FrancescoLanthaler/BeeBeeAte/3D-Files/STL/Omni Kupplung.stl

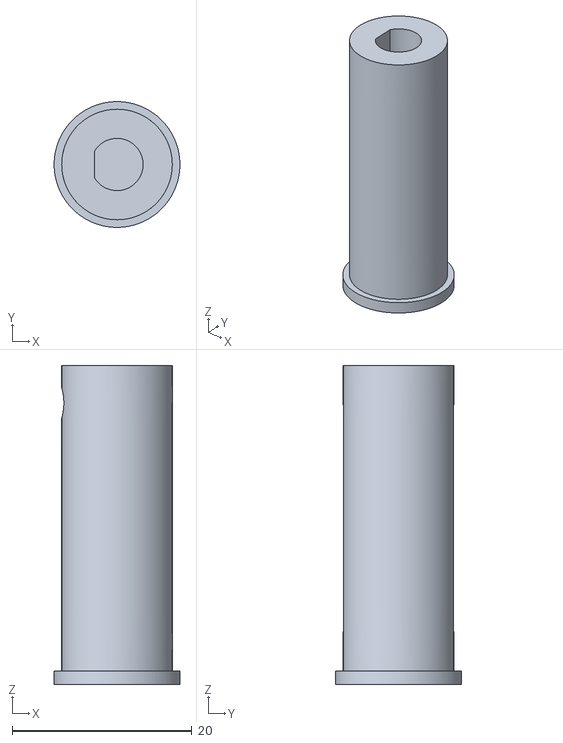
[picture p1: CAD file, 2021-12-13]
3D-Files/STL/Omni Kupplung.stl
14.0 x 14.0 x 35.5
