FrancescoLanthaler/BeeBeeAte/3D-Files/STL/BeeBeeAte-BotBoard-Case_Test1.stl

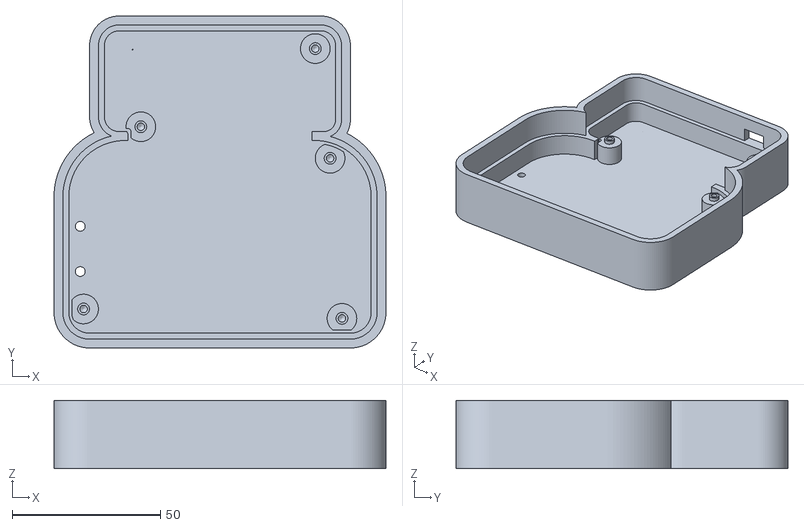
[picture p2: CAD file, 2021-11-17]
3D-Files/STL/BeeBeeAte-BotBoard-Case_Test1.stl
112.0 x 112.0 x 23.0
