FrancescoLanthaler/BeeBeeAte/3D-Files/STL/BeeBeeAte-BotBoard-Cover_Test1.stl

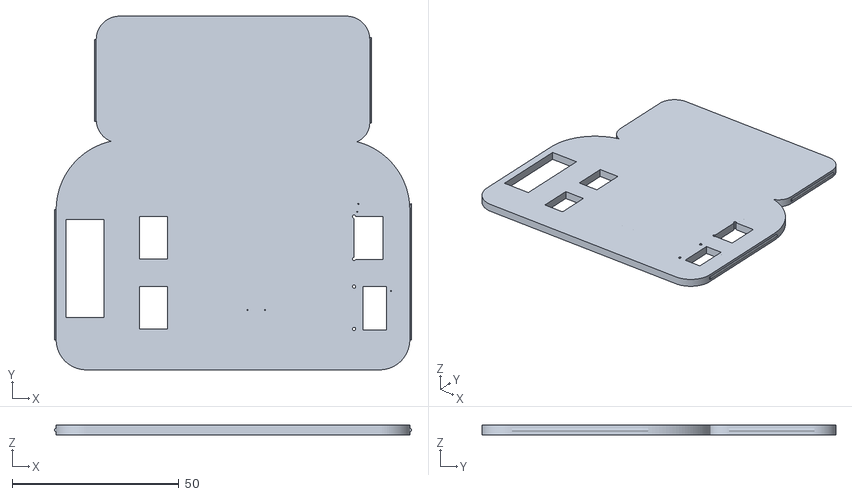
[picture p3: CAD file, 2021-11-17]
3D-Files/STL/BeeBeeAte-BotBoard-Cover_Test1.stl
107.0 x 106.0 x 3.00
