FrancescoLanthaler/BeeBeeAte/3D-Files/STL/KupplungOmni.stl

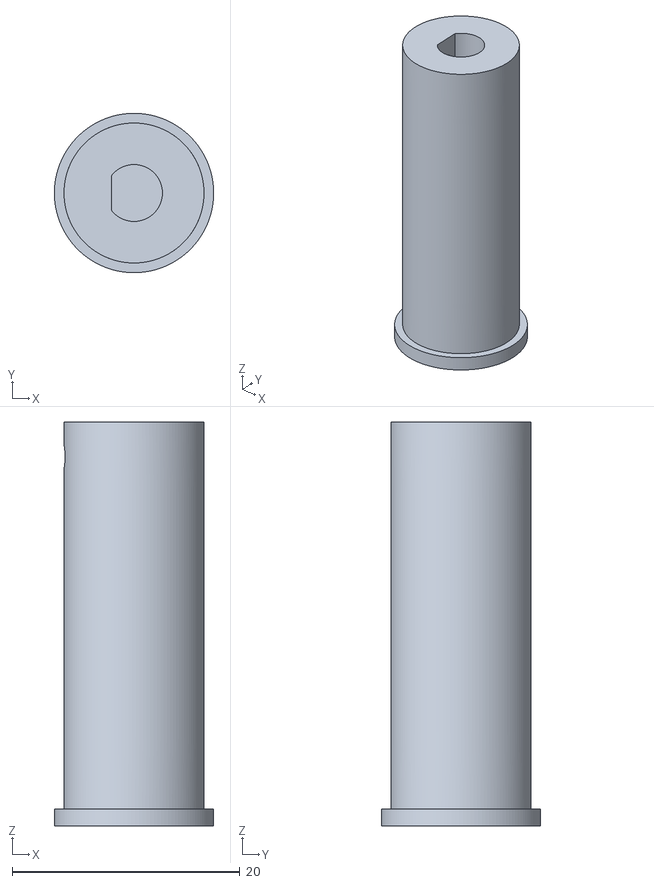
[picture p4: CAD file, 2021-11-17]
3D-Files/STL/KupplungOmni.stl
14.0 x 14.0 x 35.5
