FrancescoLanthaler/BeeBeeAte/3D-Files/STL/Fernsteuerung Cover Test 4.stl

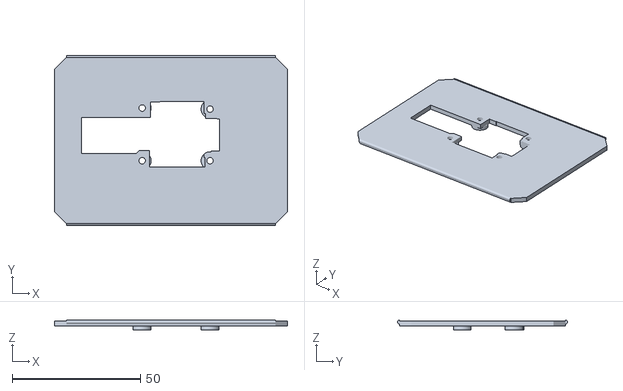
[picture p5: CAD file, 2021-11-17]
3D-Files/STL/Fernsteuerung Cover Test 4.stl
91.0 x 66.5 x 3.81
