FrancescoLanthaler/BeeBeeAte/3D-Files/STL/Cover-Test2.stl

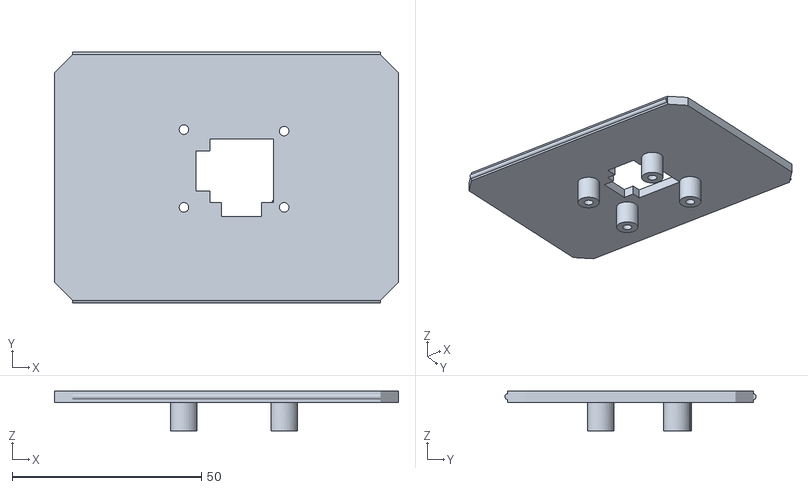
[picture p6: CAD file, 2021-11-06]
3D-Files/STL/Cover-Test2.stl
91.0 x 66.5 x 10.6
