FrancescoLanthaler/BeeBeeAte/3D-Files/STL/Cover-Test3.stl

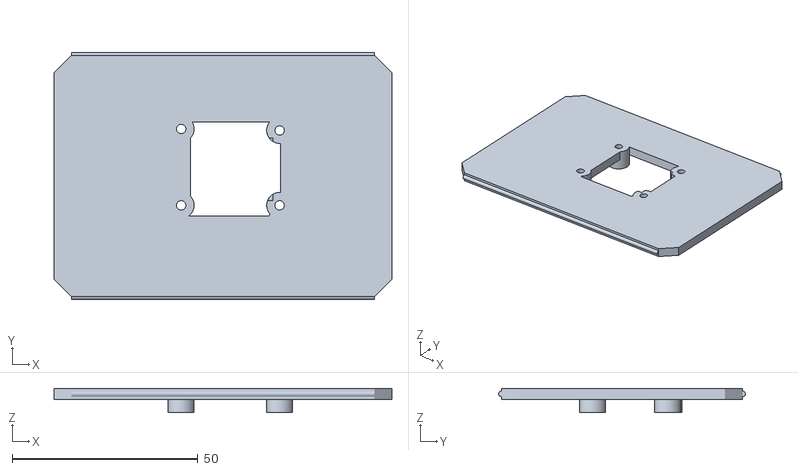
[picture p7: CAD file, 2021-11-06]
3D-Files/STL/Cover-Test3.stl
91.0 x 66.5 x 6.56
