FrancescoLanthaler/BeeBeeAte/(list of files, cad)

Other CAD files:
3D-Files/STL/BeeBeeAte-BotBoard-Case_Test2.stl
3D-Files/STL/KupplungOmniV2.stl
