FrancescoLanthaler/BeeBeeAte/EAGLE/Version 1/BotBoardBRD.pdf

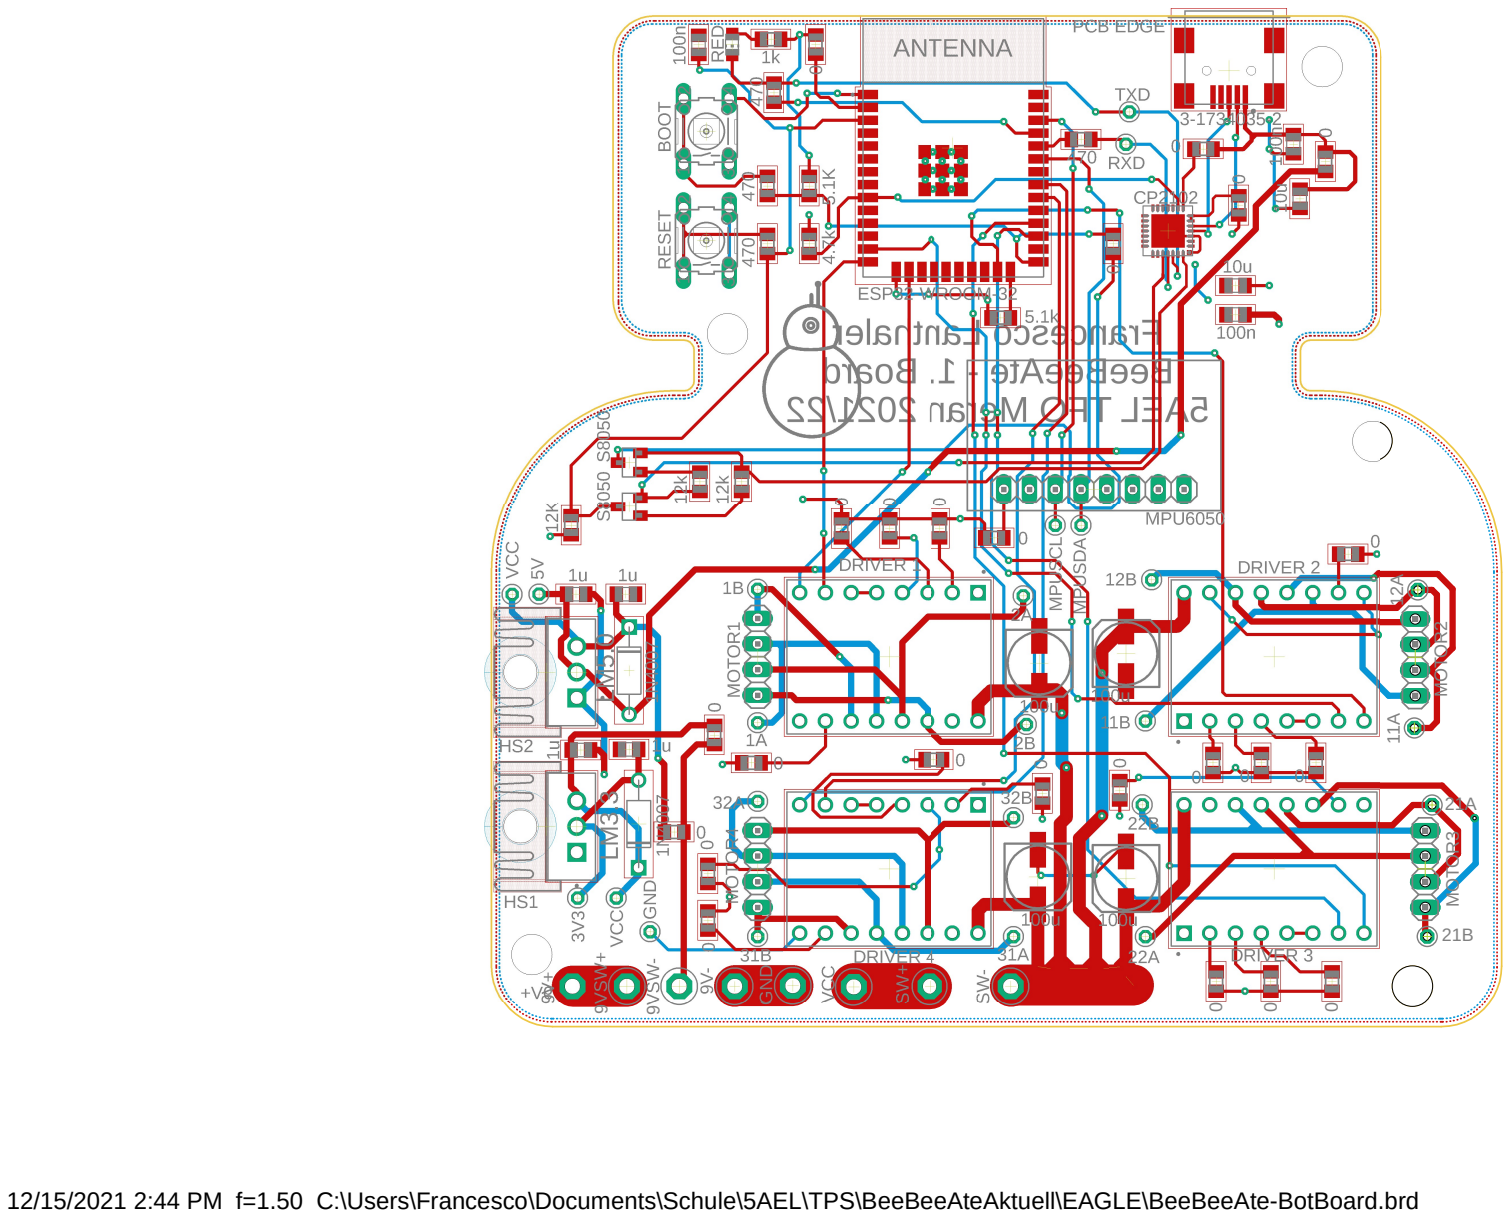
[picture p8: page 1]
9V+ MOTOR2 MOTOR3 SW+ SW- 0; 21B GND; VCC 9VSW⁺; 9VSW⁻

12/15/2021 2:44 PM f=1.50 C:\Users\Francesco\Documents\Schule\5AEL\TPS\BeeBeeAteAktuell\EAGLE\BeeBeeAte-BotBoard.brd
