FrancescoLanthaler/BeeBeeAte/EAGLE/Version 1/BotBoardSCH.pdf

# Stromversorgung

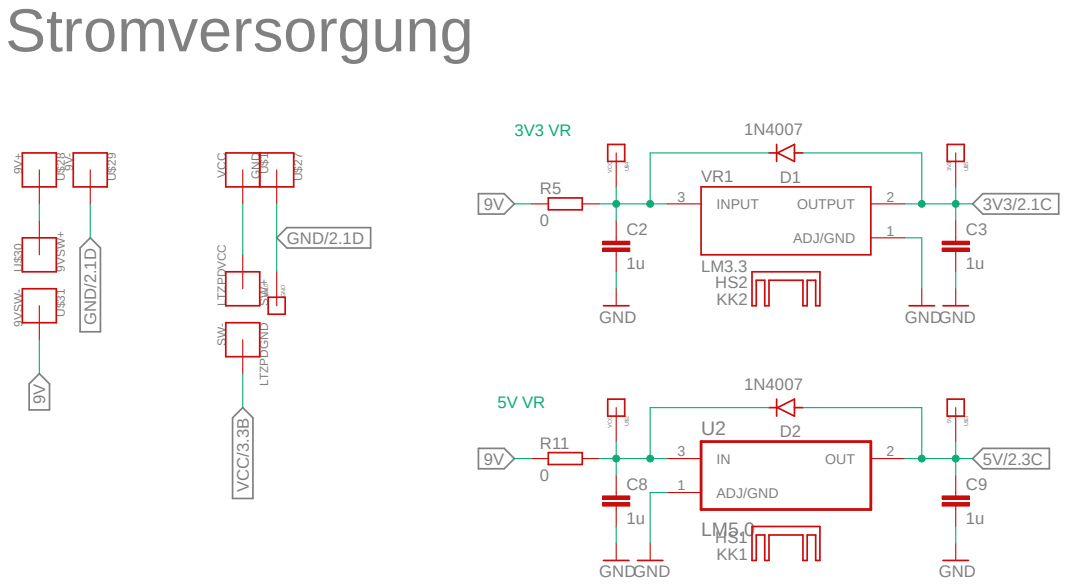
[picture p9: page 1]

12/15/2021 2:44 PM C:\Users\Francesco\Documents\Schule\5AEL\TPS\BeeBeeAteAktuell\EAGLE\BeeBeeAte-BotBoard.sch (Sheet: 1/4)

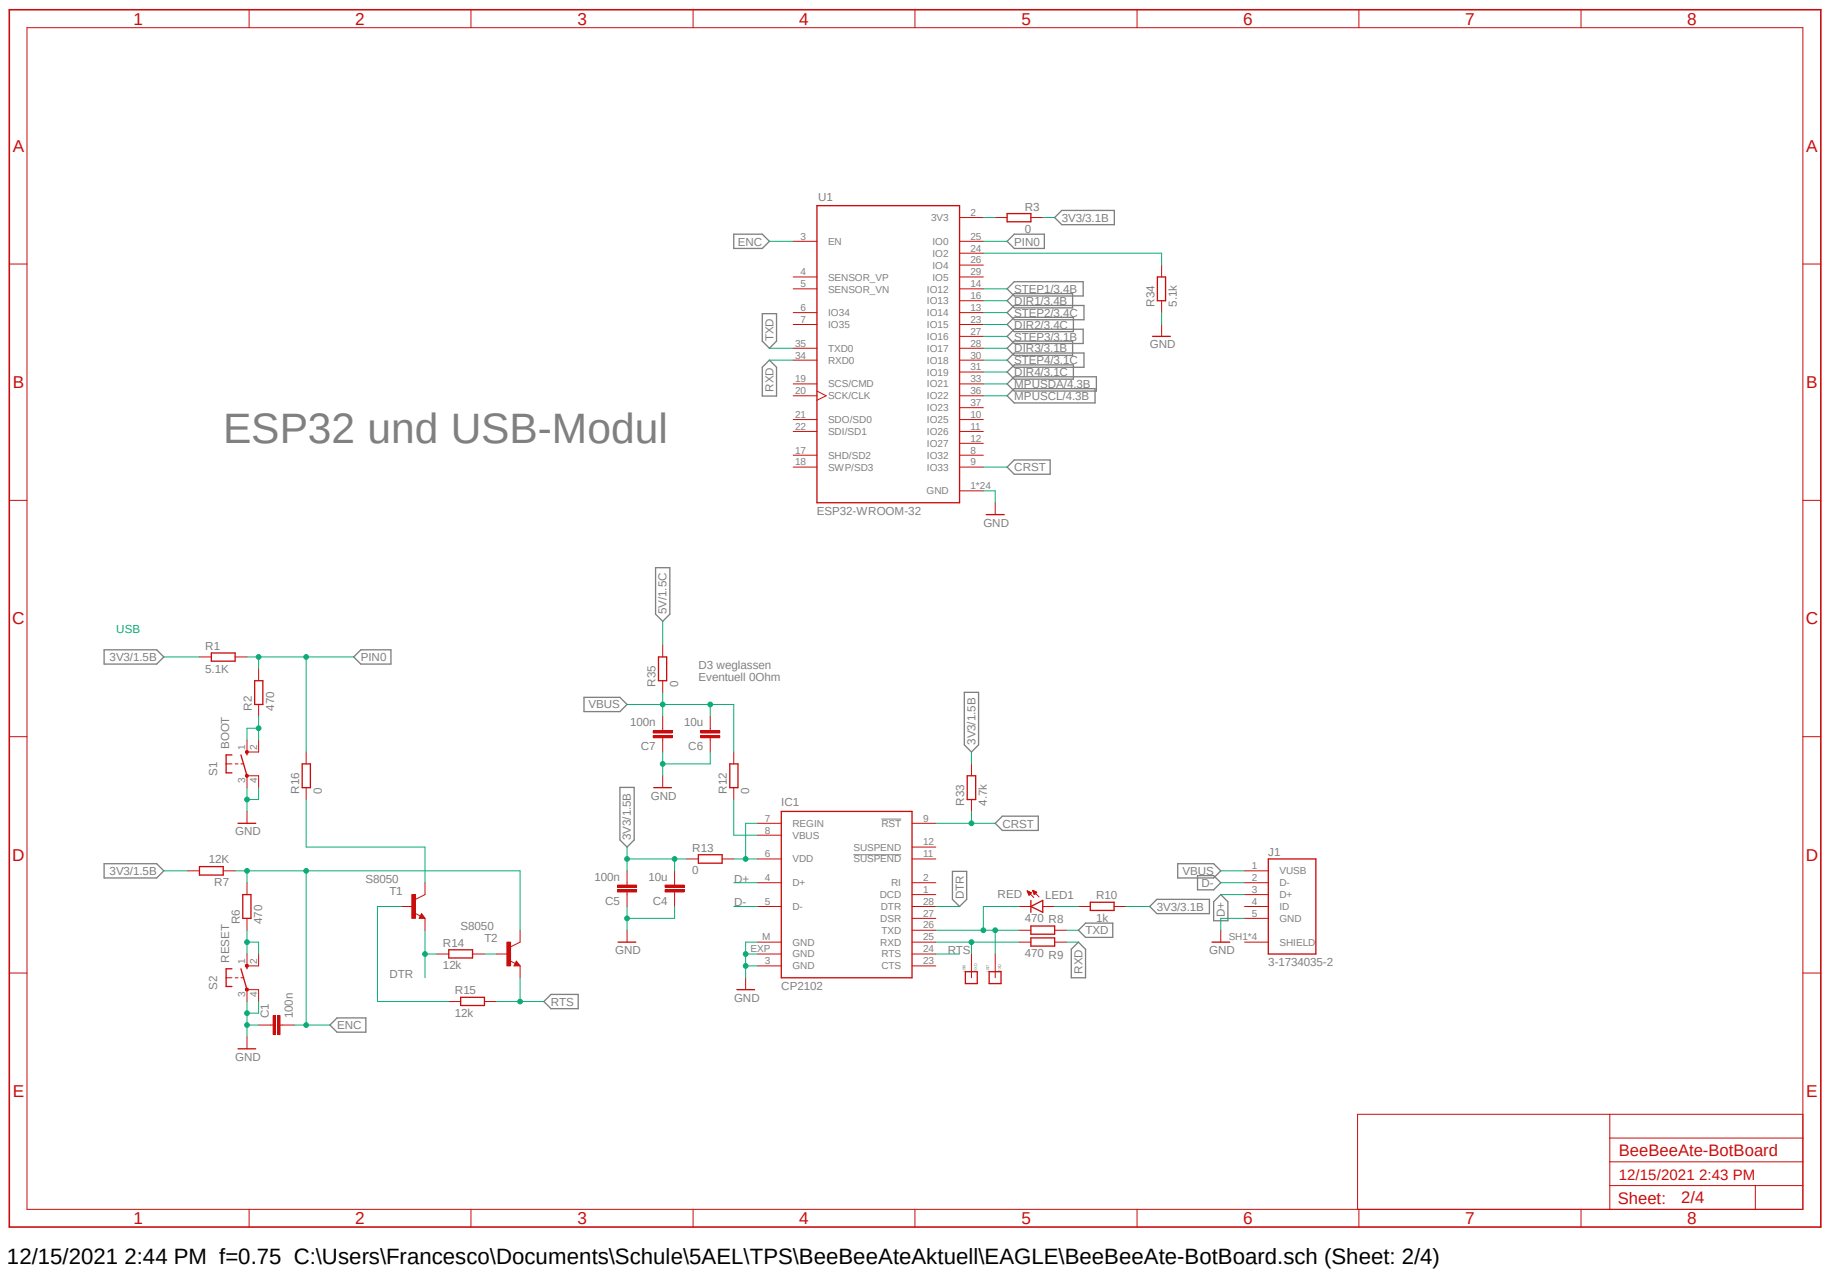
[picture p10: page 2]

12/15/2021 2:44 PM f=0.75 C:\Users\Francesco\Documents\Schule\5AEL\TPS\BeeBeeAteAktuell\EAGLE\BeeBeeAte-BotBoard.sch (Sheet: 2/4)

# Motoren Treiber

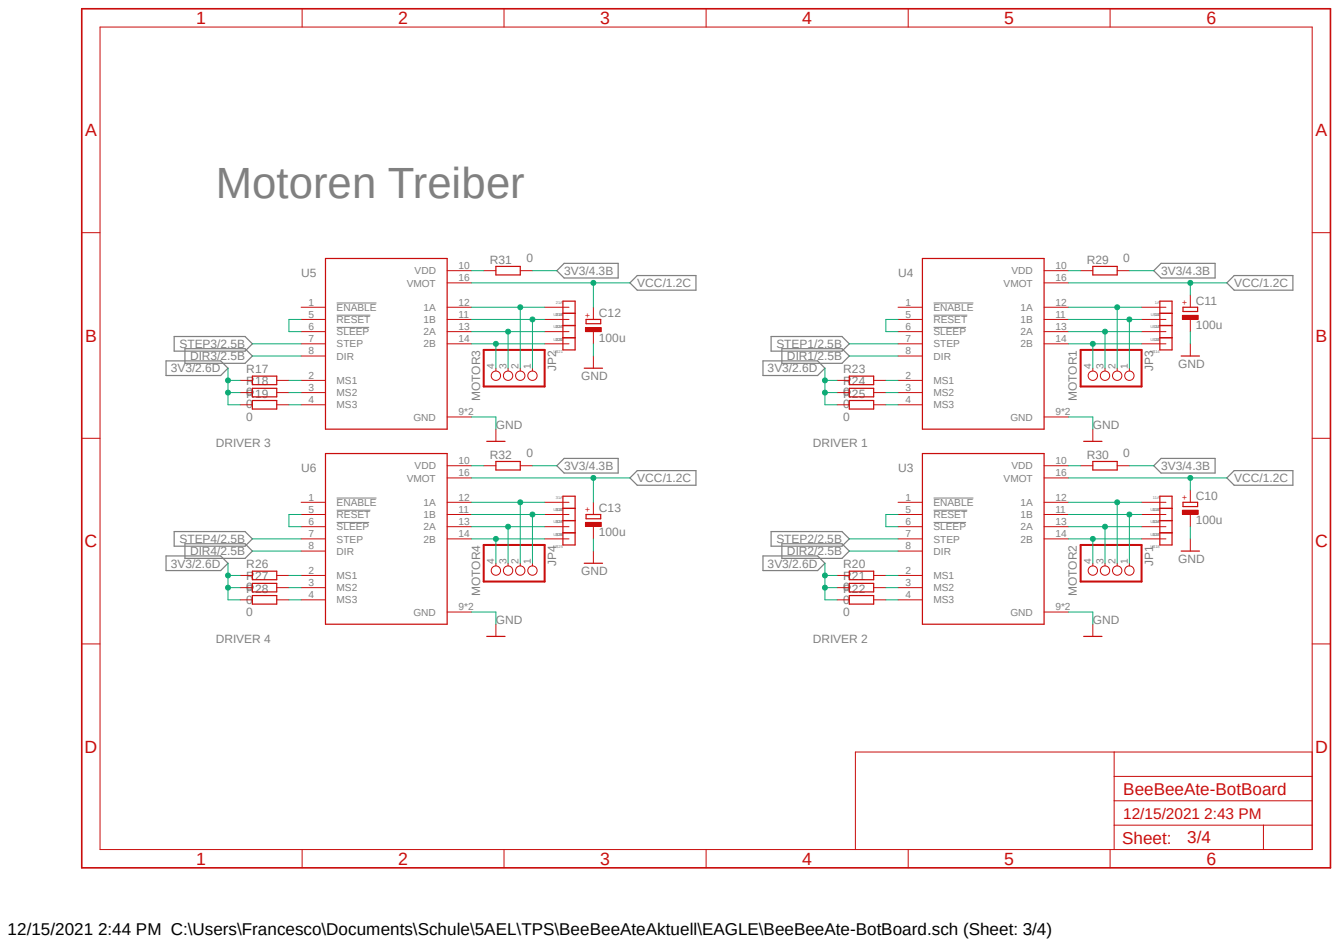
[picture p11: page 3]

12/15/2021 2:44 PM C:\Users\Francesco\Documents\Schule\5AEL\TPS\BeeBeeAteAktuell\EAGLE\BeeBeeAte-BotBoard.sch (Sheet: 3/4)

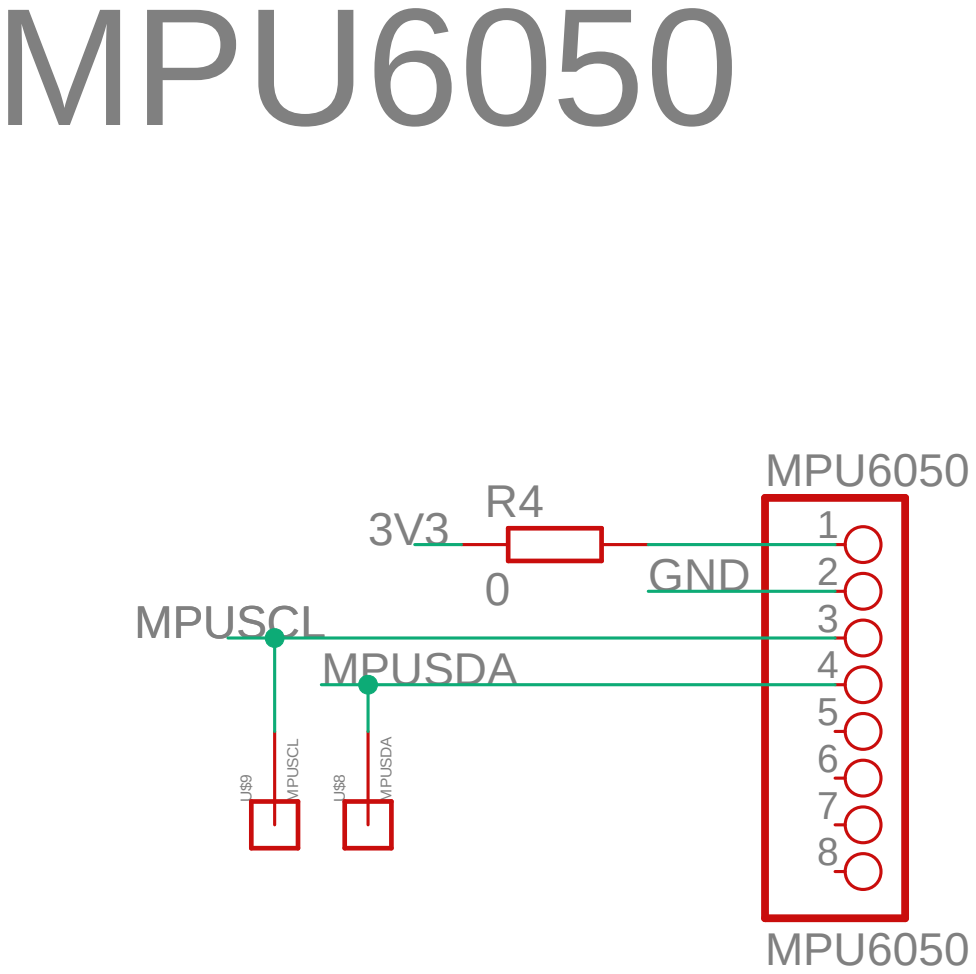
[picture p12: page 4]
MPU6050; 0 MPUSCL; MPUSDA; 8 MPU6050 R4 U$9; GND; MPUSCL MPUSDA; Sheet:; BeeBeeAte-BotBoard

12/15/2021 2:44 PM C:\Users\Francesco\Documents\Schule\5AEL\TPS\BeeBeeAteAktuell\EAGLE\BeeBeeAte-BotBoard.sch (Sheet: 4/4)
