FrancescoLanthaler/BeeBeeAte/EAGLE/Version 1/RemoteBoardBRD.pdf

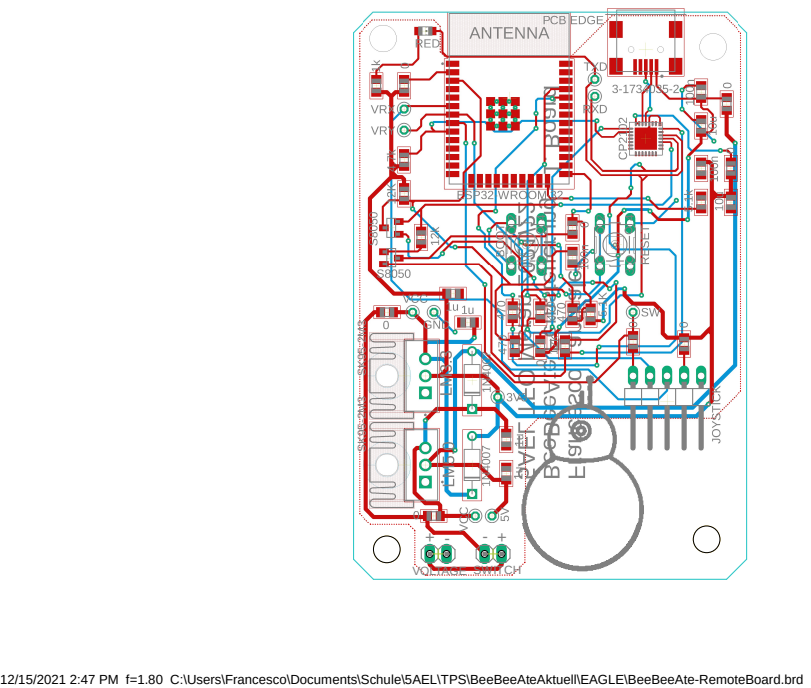
[picture p13: page 1]

VOLTAGE SWITCH VCC SK⁹⁵⁻²M³ SK⁹⁵⁻²M³

12/15/2021 2:47 PM f=1.80 C:\Users\Francesco\Documents\Schule\5AEL\TPS\BeeBeeAteAktuell\EAGLE\BeeBeeAte-RemoteBoard.brd
