FrancescoLanthaler/BeeBeeAte/EAGLE/Version 1/RemoteBoardSCH.pdf

# Stromversorgung

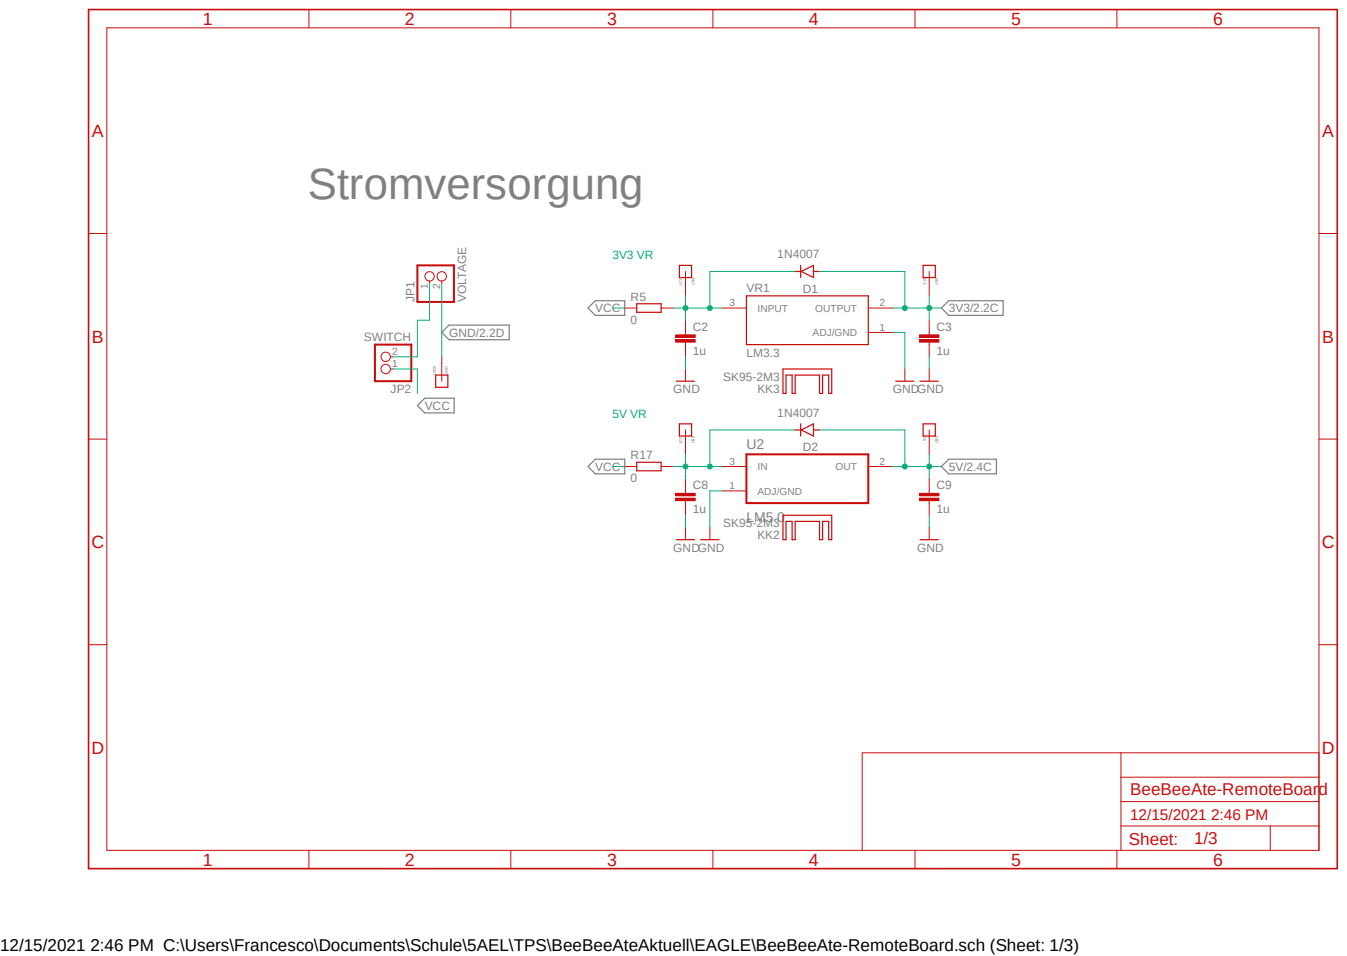
[picture p14: page 1]

12/15/2021 2:46 PM C:\Users\Francesco\Documents\Schule\5AEL\TPS\BeeBeeAteAktuell\EAGLE\BeeBeeAte-RemoteBoard.sch (Sheet: 1/3)

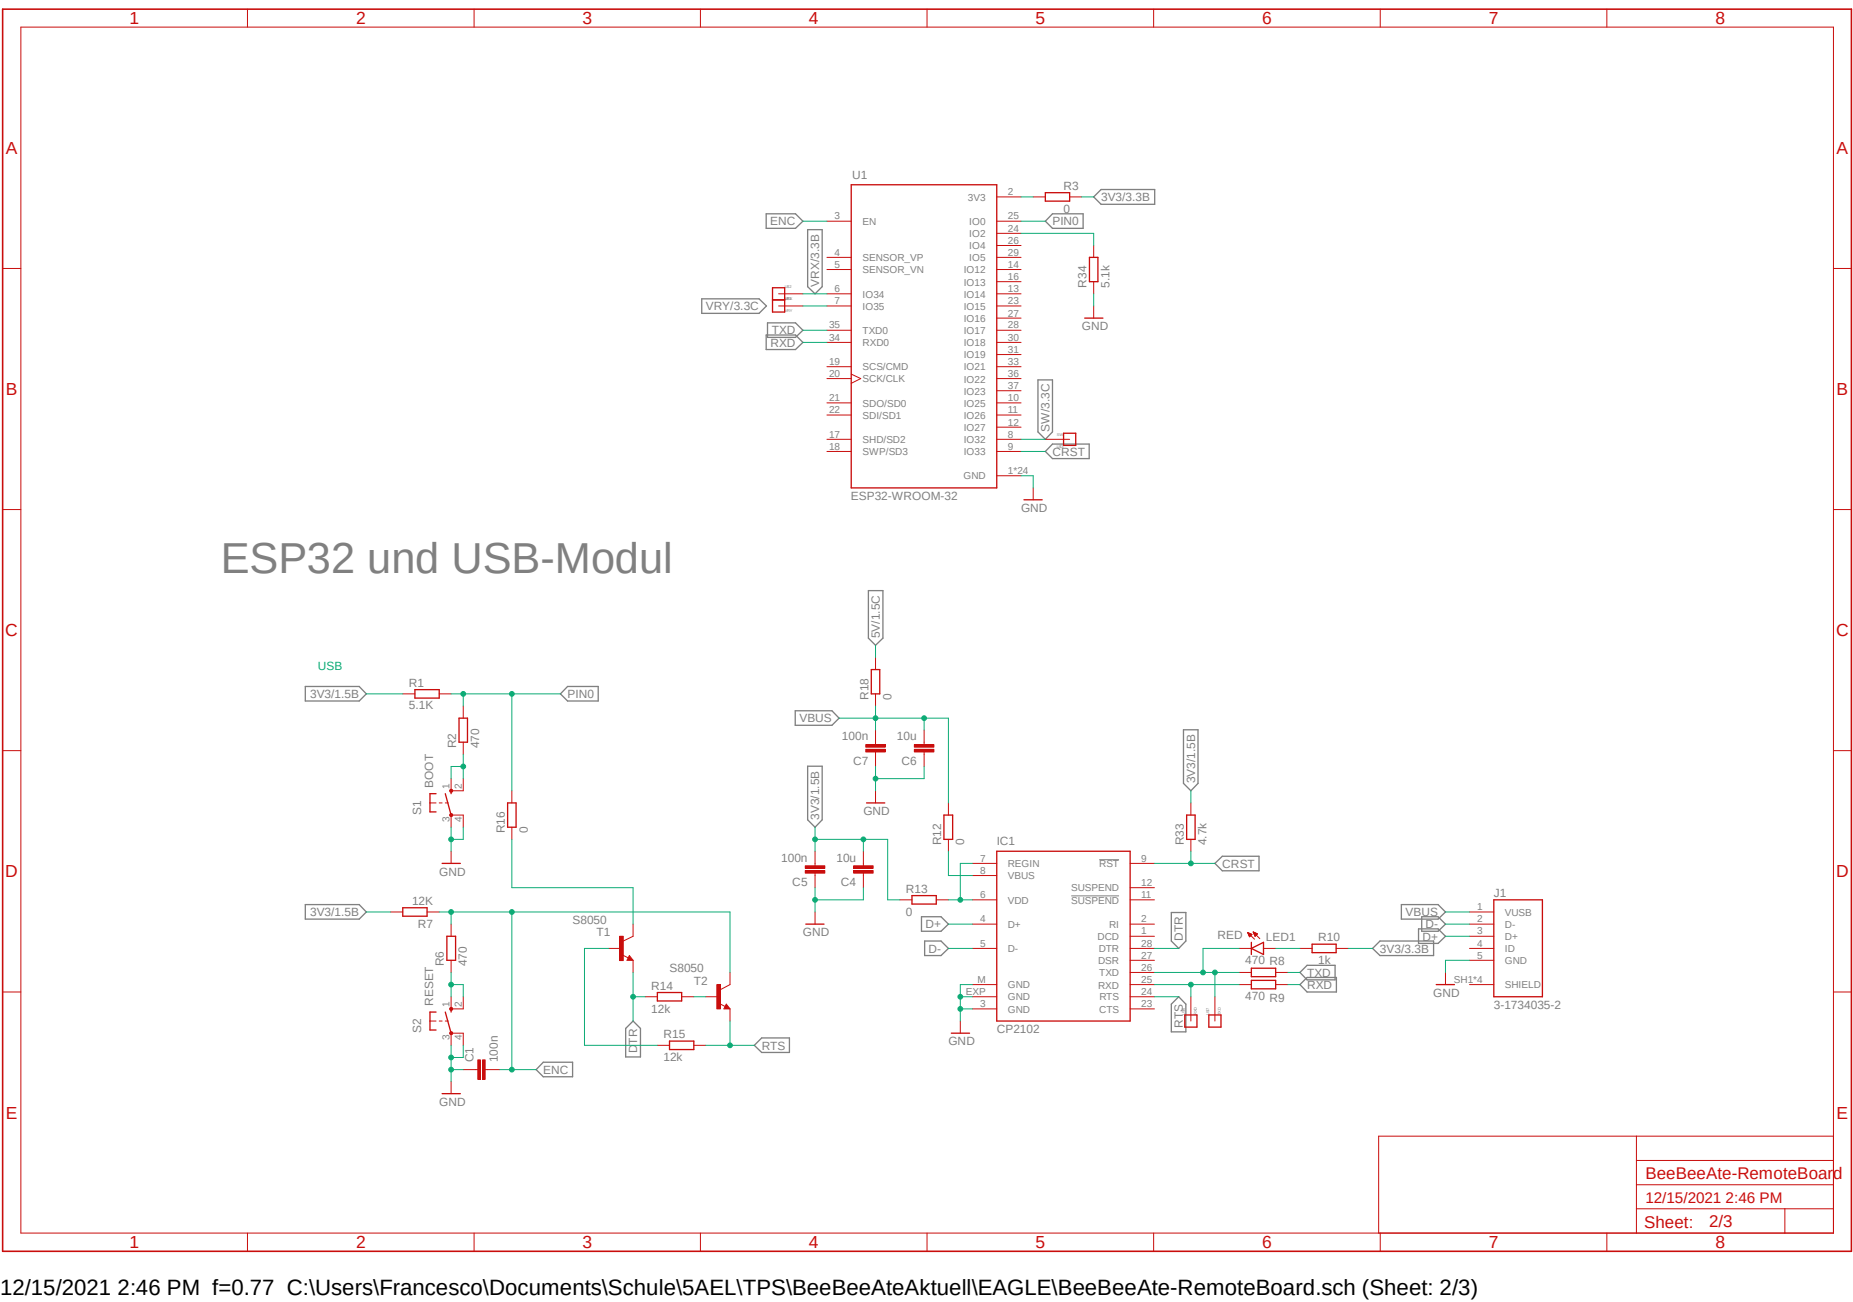
[picture p15: page 2]

12/15/2021 2:46 PM f=0.77 C:\Users\Francesco\Documents\Schule\5AEL\TPS\BeeBeeAteAktuell\EAGLE\BeeBeeAte-RemoteBoard.sch (Sheet: 2/3)

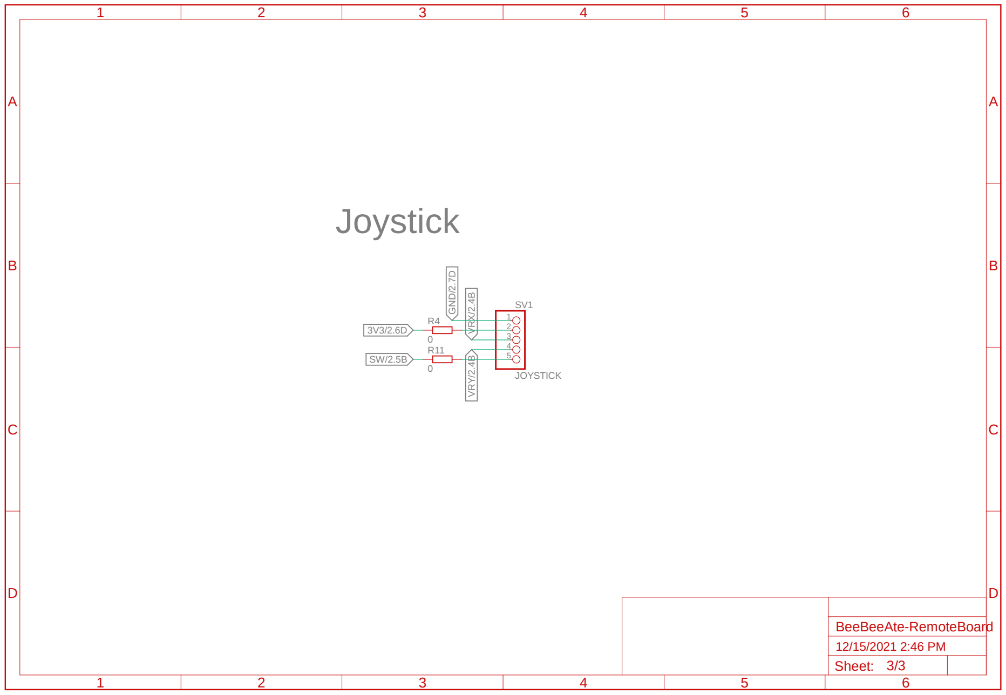
[picture p16: figure]
Joystick; JOYSTICK; GND/2.7D; VRX/2.4B VRY/2.4BSW/2.5B; Sheet:; BeeBeeAte-RemoteBoard

12/15/2021 2:46 PM C:\Users\Francesco\Documents\Schule\5AEL\TPS\BeeBeeAteAktuell\EAGLE\BeeBeeAte-RemoteBoard.sch (Sheet: 3/3)
