FrancescoLanthaler/BeeBeeAte/EAGLE/Version 2/BeeBeeAte-BotBoardV2.brd

## EAGLE design EAGLE/Version 2/BeeBeeAte-BotBoardV2.brd (2022-02-16)

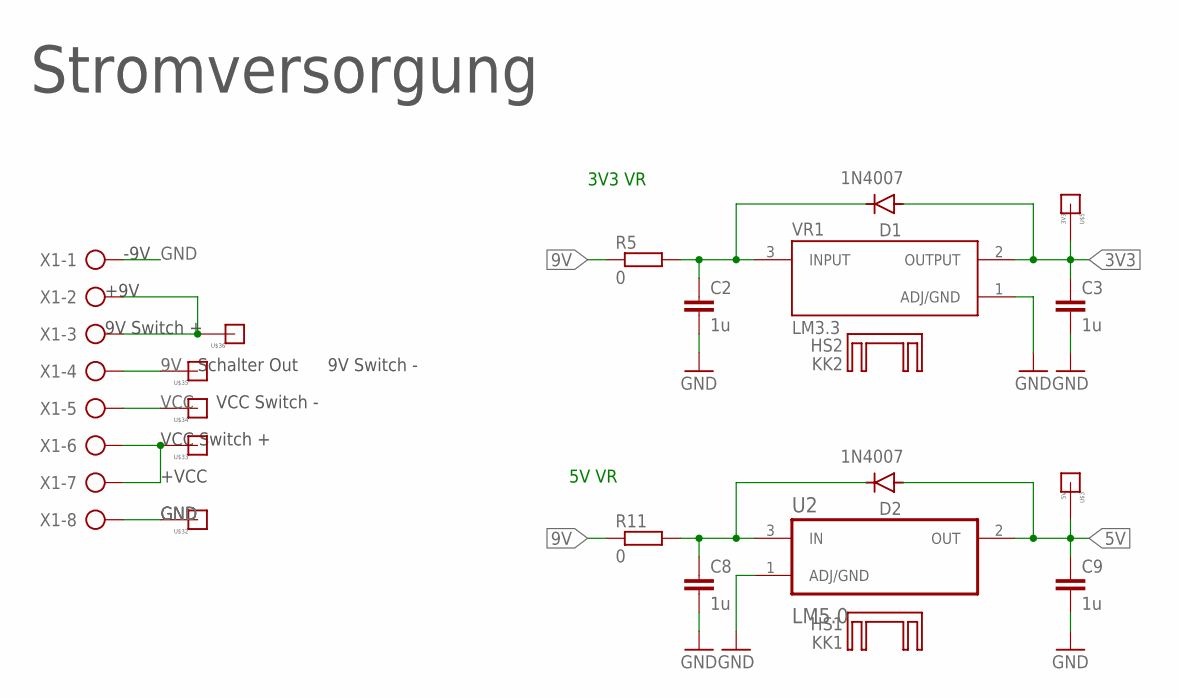
[picture p17: schematic BeeBeeAte-BotBoardV2.sch, sheet 1, Power Supply]

Parts:
C2, C3, C8, C9: 1u; C0805
D1, D2: 1N4007; DO-41
KK1: HS1; SK95-2M3
KK2: HS2; SK95-2M3
R5, R11: 0; R0805
U2: LM5.0; TO254P1054X470X1955-3
U$3: 5V; MESSPAD
U$5: 3V3; MESSPAD
U$32, U$33, U$34, U$35, U$36: MESSPAD
VR1: LM3.3; TO254P1054X470X1955-3
X1: +9V; AK300/8

Connections:
3V3: C3.1, D1.A, U$5.MSP, VR1.2 (OUTPUT); also elsewhere on the board
5V: C9.1, D2.A, U2.2 (OUT), U$3.MSP; also elsewhere on the board
9V: R5.1, R11.1, U$35.MSP, X1.4
+VCC: U$33.MSP, X1.6, X1.7
GND: C2.2, C3.2, C8.2, C9.2, U2.1 (ADJ/GND), U$32.MSP, VR1.1 (ADJ/GND), X1.1, X1.8; also elsewhere on the board
unnamed: C2.1, D1.C, R5.2, VR1.3 (INPUT)
unnamed: C8.1, D2.C, R11.2, U2.3 (IN)
unnamed: U$36.MSP, X1.2, X1.3
VCC: U$34.MSP, X1.5; also elsewhere on the board

Notes on the sheet:
5V VR
3V3 VR
Stromversorgung
Schalter Out
9V Switch +
9V Switch -
+9V
-9V
VCC Switch -
+VCC
VCC Switch +

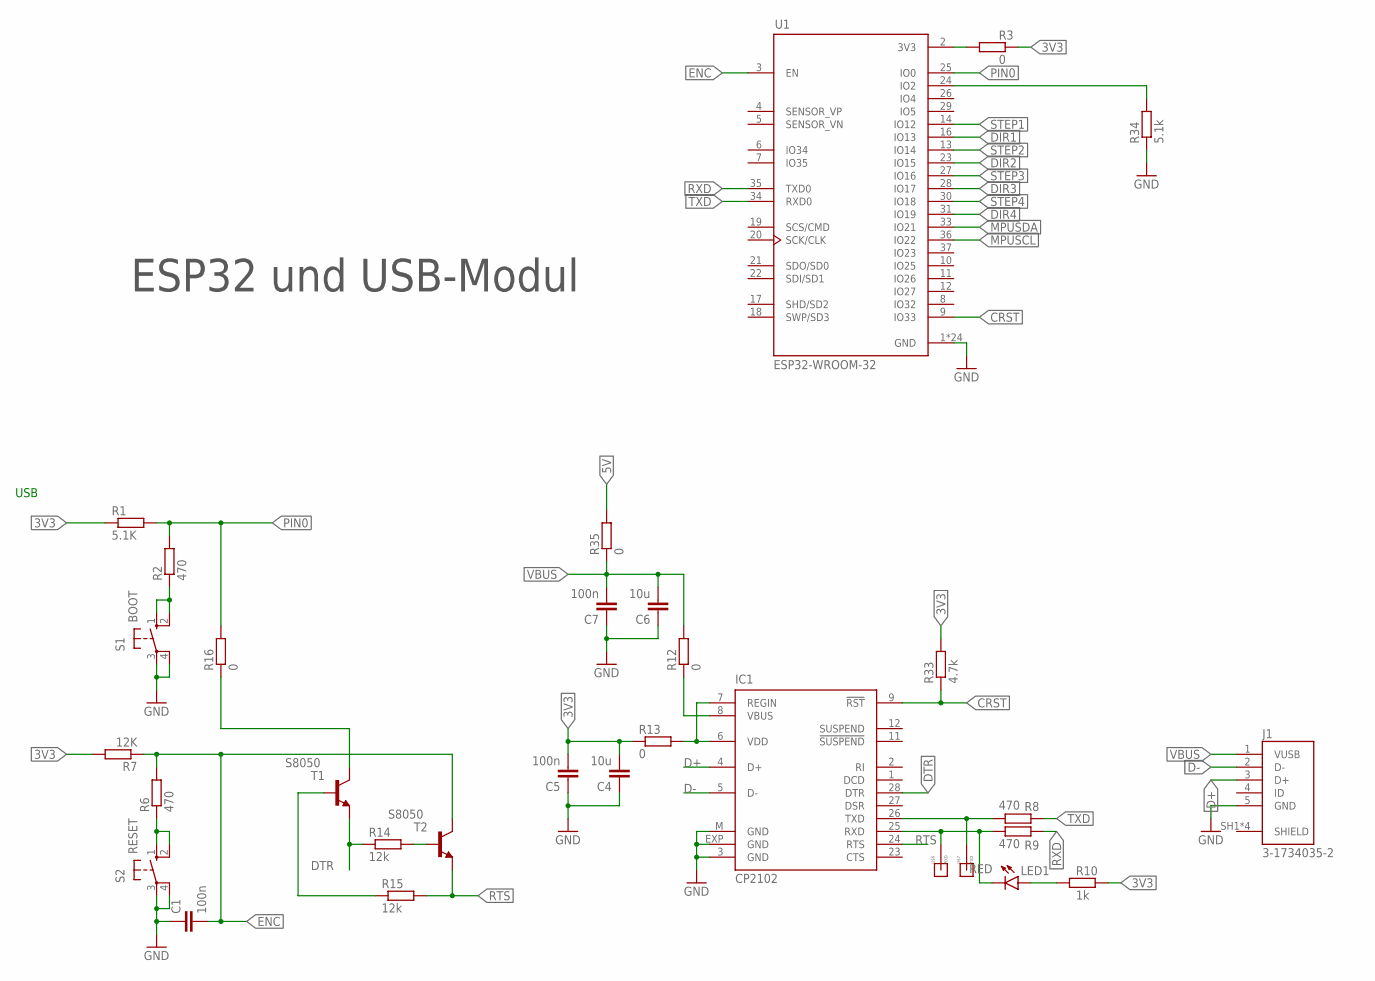
[picture p18: schematic BeeBeeAte-BotBoardV2.sch, sheet 2, ESP32 und USB Modul]

Parts:
C1, C5, C7: 100n; C0805
C4, C6: 10u; C0805
IC1: CP2102; MLP28
J1: 3-1734035-2; TE_3-1734035-2
LED1: RED; CHIP-LED0805
R1: 5.1K; R0805
R2, R6, R8, R9: 470; R0805
R3, R12, R13, R16, R35: 0; R0805
R7: 12K; R0805
R10: 1k; R0805
R14, R15: 12k; R0805
R33: 4.7k; R0805
R34: 5.1k; R0805
S1: BOOT; B3F-10XX
S2: RESET; B3F-10XX
T1, T2: S8050; SOT23-BEC
U1: ESP32-WROOM-32; MODULE_ESP32-WROOM-32
U$6: RXD; MESSPAD
U$7: TXD; MESSPAD

Connections:
3V3: C4.2, C5.2, R1.1, R3.2, R7.2, R10.2, R13.1, R33.2; also elsewhere on the board
5V: R35.2; also elsewhere on the board
CRST: IC1.9 (!RST), R33.1, U1.9 (IO33)
D+: IC1.4 (D+), J1.3 (D+)
D-: IC1.5 (D-), J1.2 (D-)
DIR1: U1.16 (IO13); also elsewhere on the board
DIR2: U1.23 (IO15); also elsewhere on the board
DIR3: U1.28 (IO17); also elsewhere on the board
DIR4: U1.31 (IO19); also elsewhere on the board
DTR: IC1.28 (DTR), R14.1, T1.E
ENC: C1.2, R6.2, R7.1, T2.C, U1.3 (EN)
GND: C1.1, C4.1, C5.1, C6.1, C7.1, IC1.3 (GND), IC1.EXP (GND), IC1.M (GND), J1.5 (GND), R34.1, S1.3, S1.4 (P1), S2.3, S2.4 (P1), U1.1 (GND), U1.15 (GND), U1.38 (GND), U1.39_1 (GND), U1.39_2 (GND), U1.39_3 (GND), U1.39_4 (GND), U1.39_5 (GND), U1.39_6 (GND), U1.39_7 (GND), U1.39_8 (GND), U1.39_9 (GND), U1.39_10 (GND), U1.39_11 (GND), U1.39_12 (GND), U1.39_13 (GND), U1.39_14 (GND), U1.39_15 (GND), U1.39_16 (GND), U1.39_17 (GND), U1.39_18 (GND), U1.39_19 (GND), U1.39_20 (GND), U1.39_21 (GND); also elsewhere on the board
MPUSCL: U1.36 (IO22); also elsewhere on the board
MPUSDA: U1.33 (IO21); also elsewhere on the board
unnamed: R2.1, S1.1 (S), S1.2 (S1)
unnamed: R6.1, S2.1 (S), S2.2 (S1)
unnamed: IC1.25 (RXD), LED1.C, R9.1, U$6.MSP
unnamed: LED1.A, R10.1
unnamed: IC1.26 (TXD), R8.1, U$7.MSP
unnamed: IC1.6 (VDD), IC1.7 (REGIN), R13.2
unnamed: IC1.8 (VBUS), R12.1
unnamed: R14.2, T2.B
unnamed: R15.1, T1.B
unnamed: R34.2, U1.24 (IO2)
unnamed: R3.1, U1.2 (3V3)
PIN0: R1.2, R2.2, R16.2, U1.25 (IO0)
PIN1: R16.1, T1.C
RTS: IC1.24 (RTS), R15.2, T2.E
RXD: R9.2, U1.35 (TXD0)
STEP1: U1.14 (IO12); also elsewhere on the board
STEP2: U1.13 (IO14); also elsewhere on the board
STEP3: U1.27 (IO16); also elsewhere on the board
STEP4: U1.30 (IO18); also elsewhere on the board
TXD: R8.2, U1.34 (RXD0)
VBUS: C6.2, C7.2, J1.1 (VUSB), R12.2, R35.1

Notes on the sheet:
USB
ESP32 und USB-Modul

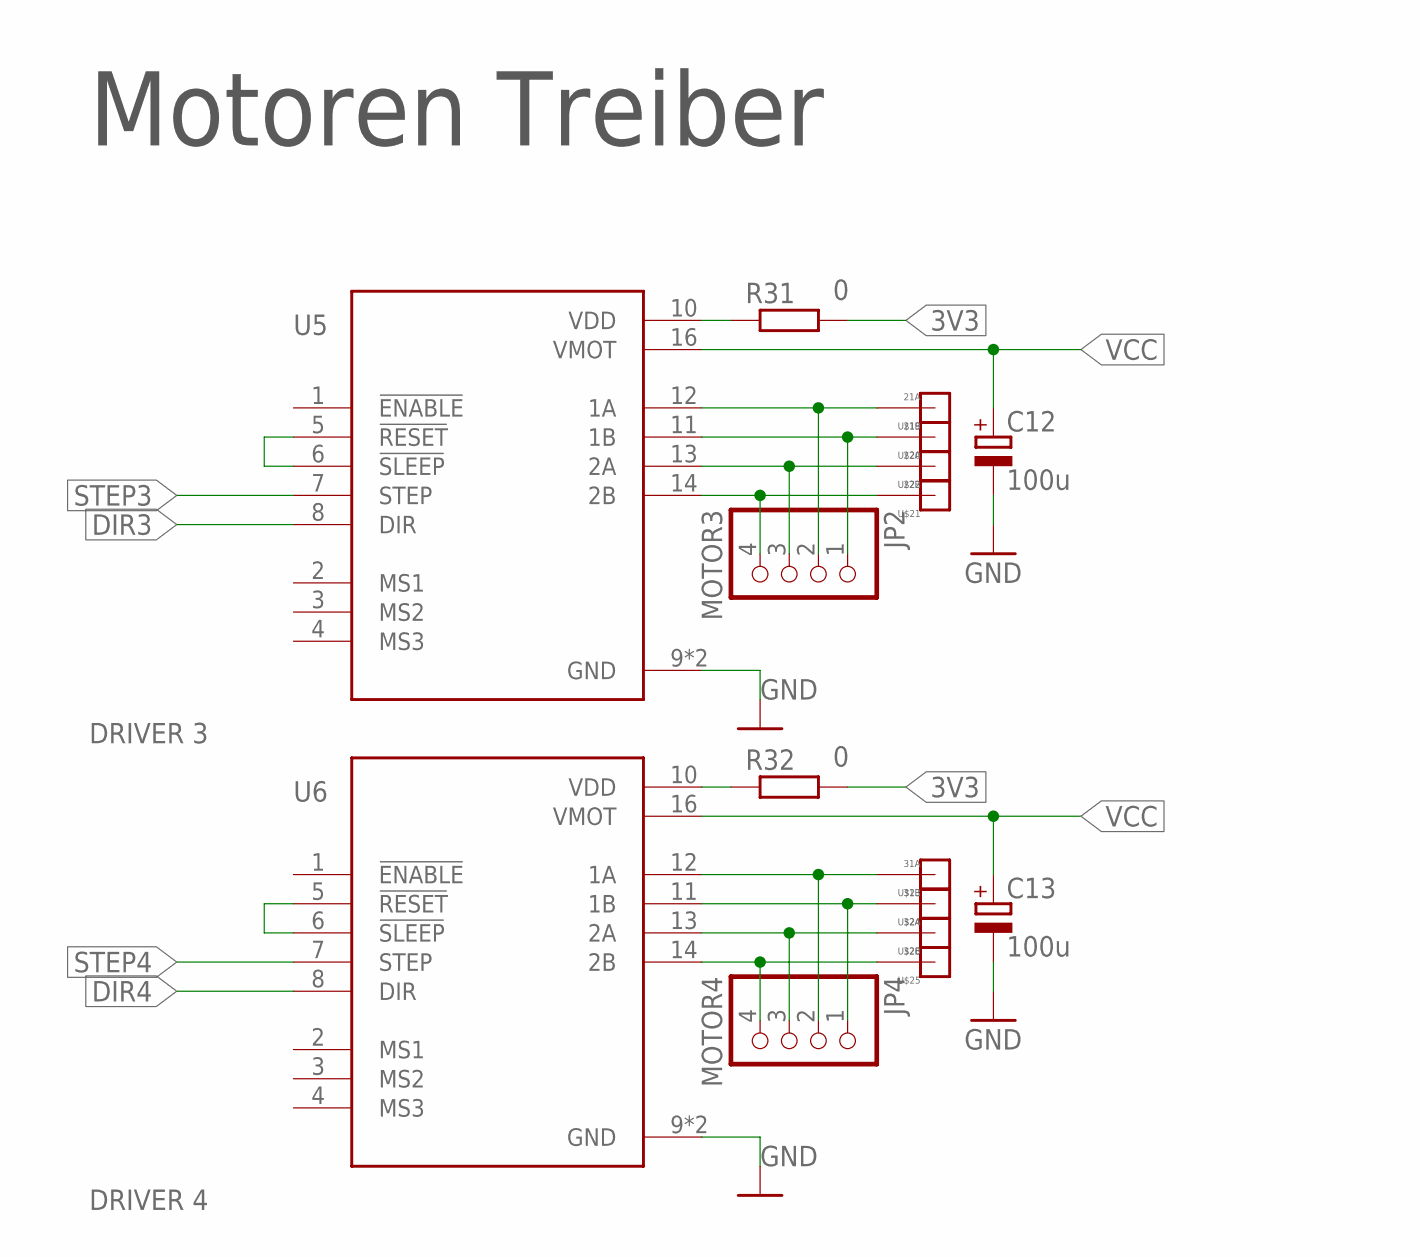
[picture p19: schematic BeeBeeAte-BotBoardV2.sch, sheet 3, Treiber für Motoren, part in row 1, column 1]

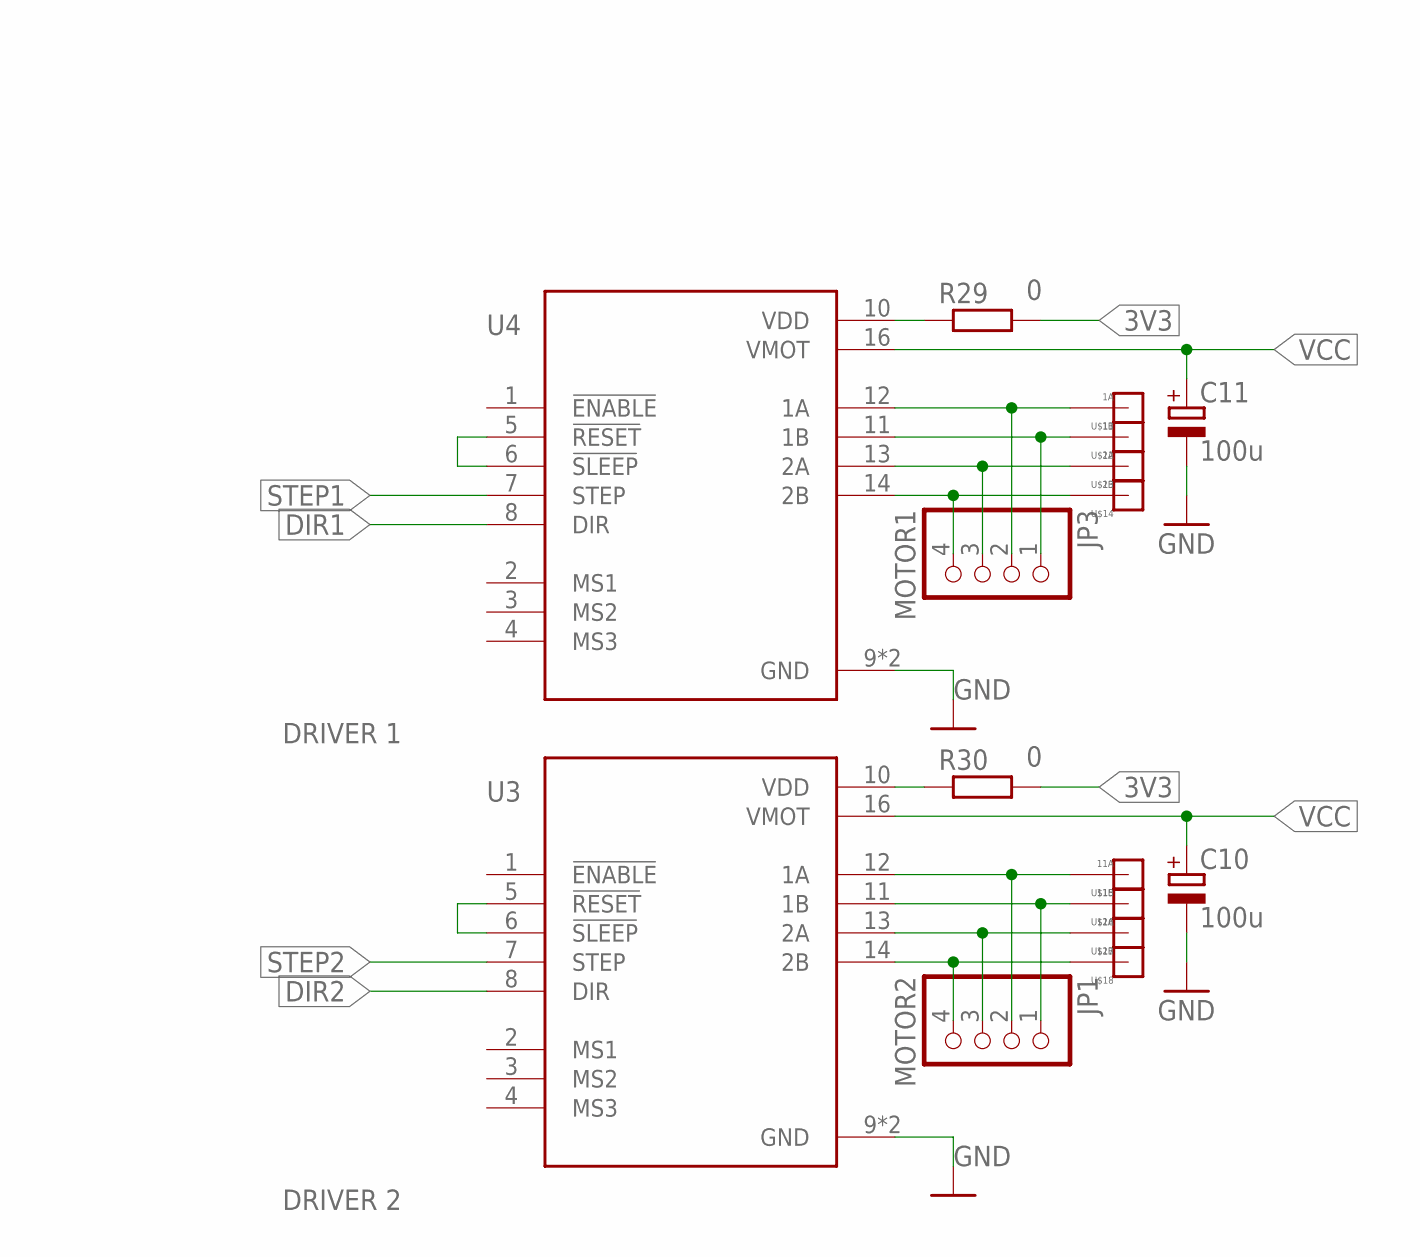
[picture p20: schematic BeeBeeAte-BotBoardV2.sch, sheet 3, Treiber für Motoren, part in row 1, column 2]

Parts:
C10, C11, C12, C13: 100u; 153CLV-0605
JP1: MOTOR2; 1X04
JP2: MOTOR3; 1X04
JP3: MOTOR1; 1X04
JP4: MOTOR4; 1X04
R29, R30, R31, R32: 0; R0805
U3: DRIVER 2; MODULE_A4988_STEPPER_MOTOR_DRIVER_CARRIER
U4: DRIVER 1; MODULE_A4988_STEPPER_MOTOR_DRIVER_CARRIER
U5: DRIVER 3; MODULE_A4988_STEPPER_MOTOR_DRIVER_CARRIER
U6: DRIVER 4; MODULE_A4988_STEPPER_MOTOR_DRIVER_CARRIER
U$11: 1A; MESSPAD
U$12: 1B; MESSPAD
U$13: 2A; MESSPAD
U$14: 2B; MESSPAD
U$15: 11A; MESSPAD
U$16: 11B; MESSPAD
U$17: 12A; MESSPAD
U$18: 12B; MESSPAD
U$19: 21A; MESSPAD
U$20: 21B; MESSPAD
U$21: 22B; MESSPAD
U$22: 22A; MESSPAD
U$23: 31A; MESSPAD
U$24: 31B; MESSPAD
U$25: 32B; MESSPAD
U$26: 32A; MESSPAD

Connections:
3V3: R29.2, R30.2, R31.2, R32.2; also elsewhere on the board
DIR1: U4.8 (DIR); also elsewhere on the board
DIR2: U3.8 (DIR); also elsewhere on the board
DIR3: U5.8 (DIR); also elsewhere on the board
DIR4: U6.8 (DIR); also elsewhere on the board
GND: C10.-, C11.-, C12.-, C13.-, U3.9 (GND), U3.15 (GND), U4.9 (GND), U4.15 (GND), U5.9 (GND), U5.15 (GND), U6.9 (GND), U6.15 (GND); also elsewhere on the board
unnamed: R30.1, U3.10 (VDD)
unnamed: JP1.2, U3.12 (1A), U$15.MSP
unnamed: JP1.1, U3.11 (1B), U$16.MSP
unnamed: JP1.3, U3.13 (2A), U$17.MSP
unnamed: JP1.4, U3.14 (2B), U$18.MSP
unnamed: U3.5 (!RESET), U3.6 (!SLEEP)
unnamed: R29.1, U4.10 (VDD)
unnamed: JP2.2, U5.12 (1A), U$19.MSP
unnamed: JP2.1, U5.11 (1B), U$20.MSP
unnamed: JP2.3, U5.13 (2A), U$22.MSP
unnamed: JP2.4, U5.14 (2B), U$21.MSP
unnamed: JP3.2, U4.12 (1A), U$11.MSP
unnamed: JP3.1, U4.11 (1B), U$12.MSP
unnamed: JP3.3, U4.13 (2A), U$13.MSP
unnamed: U5.5 (!RESET), U5.6 (!SLEEP)
unnamed: R31.1, U5.10 (VDD)
unnamed: R32.1, U6.10 (VDD)
unnamed: JP3.4, U4.14 (2B), U$14.MSP
unnamed: U4.5 (!RESET), U4.6 (!SLEEP)
unnamed: JP4.2, U6.12 (1A), U$23.MSP
unnamed: JP4.1, U6.11 (1B), U$24.MSP
unnamed: JP4.3, U6.13 (2A), U$26.MSP
unnamed: JP4.4, U6.14 (2B), U$25.MSP
unnamed: U6.5 (!RESET), U6.6 (!SLEEP)
STEP1: U4.7 (STEP); also elsewhere on the board
STEP2: U3.7 (STEP); also elsewhere on the board
STEP3: U5.7 (STEP); also elsewhere on the board
STEP4: U6.7 (STEP); also elsewhere on the board
VCC: C10.+, C11.+, C12.+, C13.+, U3.16 (VMOT), U4.16 (VMOT), U5.16 (VMOT), U6.16 (VMOT); also elsewhere on the board

Notes on the sheet:
Motoren Treiber

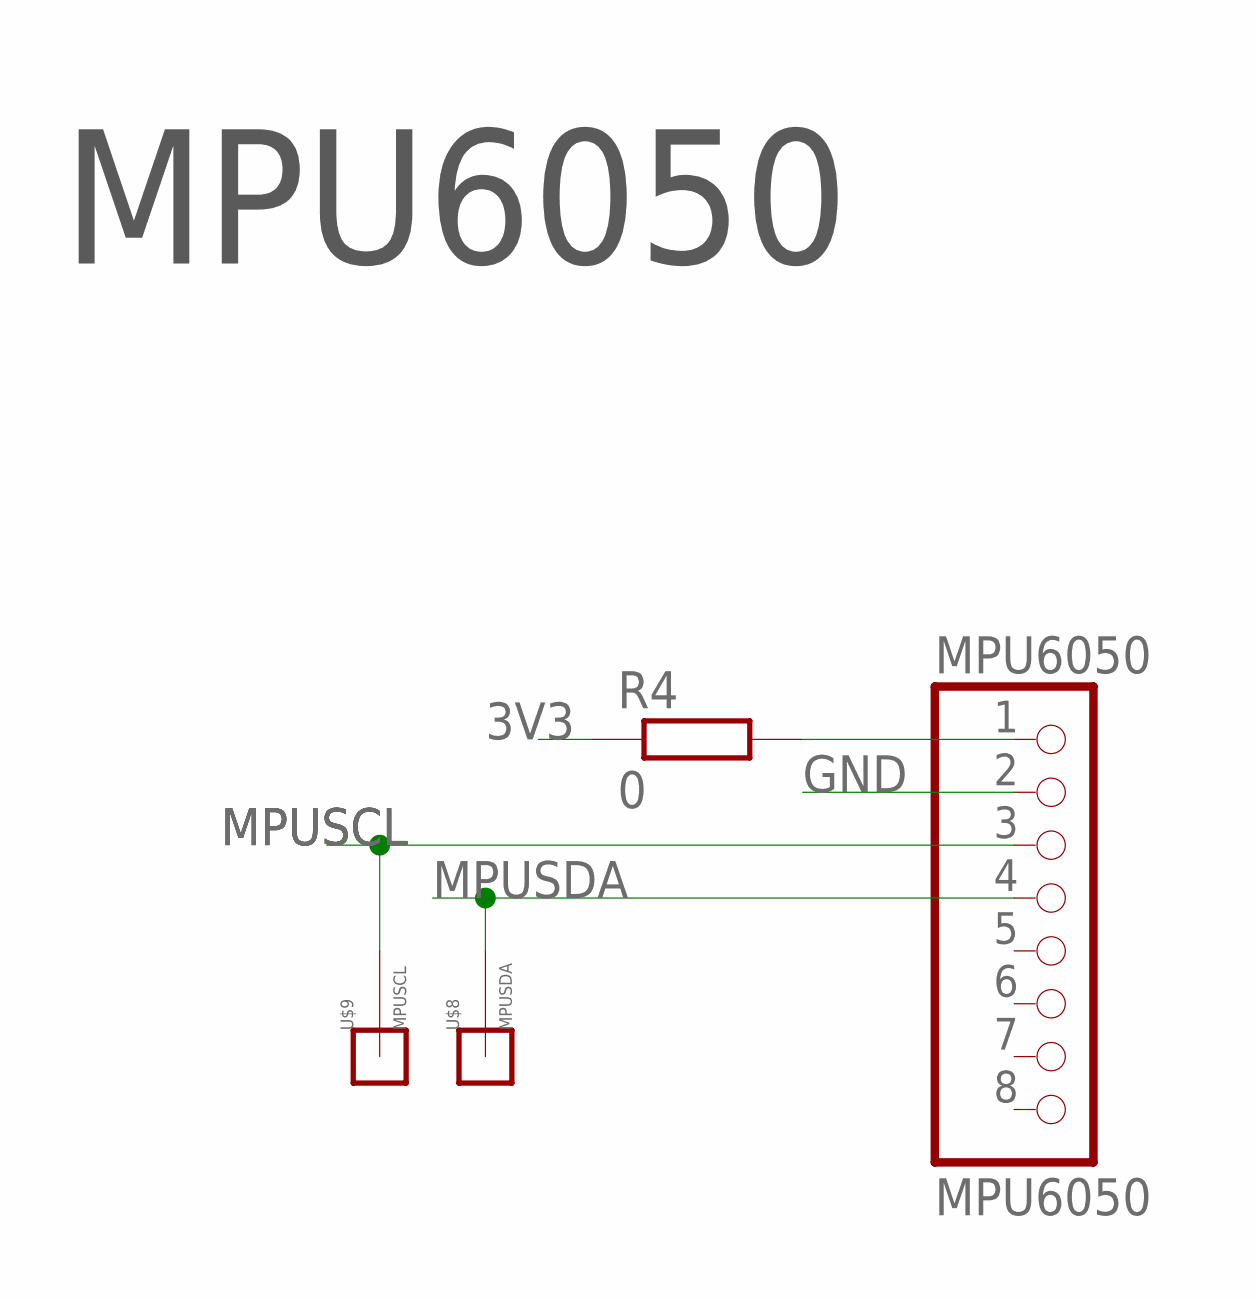
[picture p21: schematic BeeBeeAte-BotBoardV2.sch, sheet 4, MPU6050]

Parts:
MPU6050: MPU6050; 1X08
R4: 0; R0805
U$8: MPUSDA; MESSPAD
U$9: MPUSCL; MESSPAD

Connections:
3V3: R4.1; also elsewhere on the board
GND: MPU6050.2; also elsewhere on the board
MPUSCL: MPU6050.3, U$9.MSP; also elsewhere on the board
MPUSDA: MPU6050.4, U$8.MSP; also elsewhere on the board
unnamed: MPU6050.1, R4.2

Notes on the sheet:
MPU6050

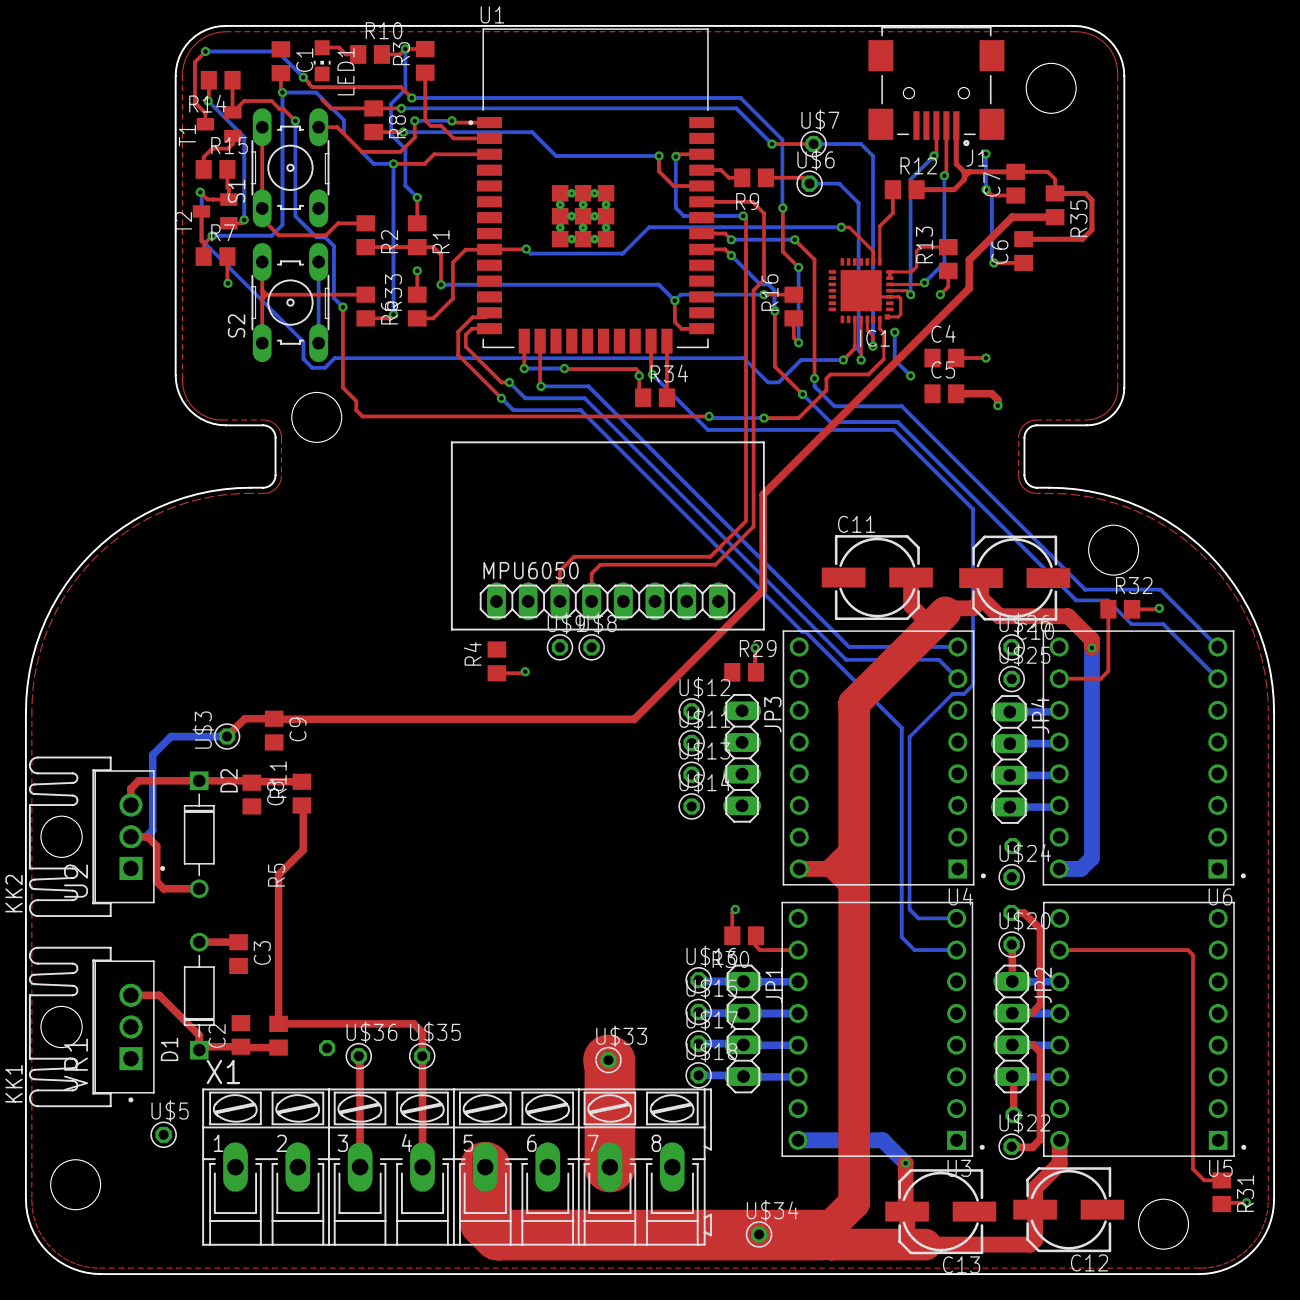
[picture p22: board BeeBeeAte-BotBoardV2.brd from above]

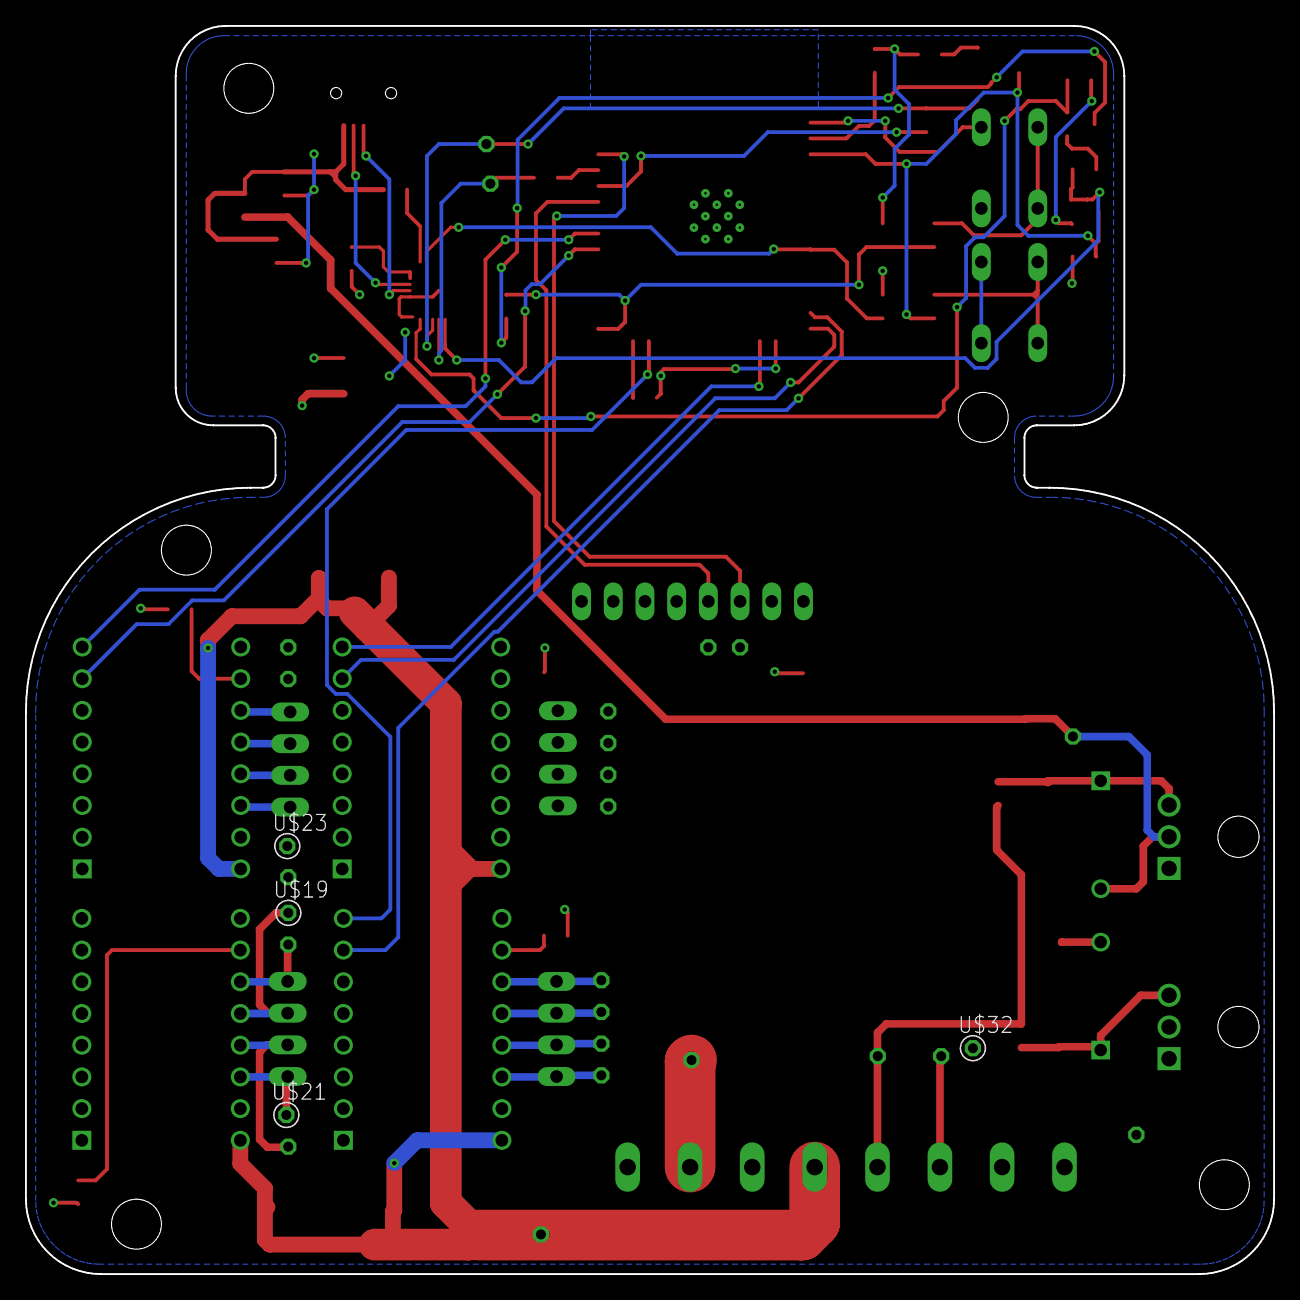
[picture p23: board BeeBeeAte-BotBoardV2.brd from below]

Board: 2 copper layers, 100.0 x 100.0 mm, 87 parts (4 on the bottom side), 66 nets.
