FrancescoLanthaler/BeeBeeAte/Code/BeeBeeAte-CodeV2/src/MOTOREN.h

#ifndef MOTOREN_H
#define MOTOREN_H

// Motor Pins
#define dirPin1 13 // Direction 1
#define stepPin1 12 // Step 1
#define dirPin2 15  // Direction 2
#define stepPin2 14 // Step 2
#define dirPin3 17  // Direction 3
#define stepPin3 16 // Step 3
#define dirPin4 19  // Direction 4
#define stepPin4 18 // Step 4

// Directions
#define forward 0
#define backward 1

// Motoren
extern double motorGain;
extern double motorStart;

extern const int motor12Channel;
extern const int motor34Channel;

extern const float toterWinkel;

// Methoden
extern void MotorSteuerung();
extern void SetupMotor();
extern void WinkelFilter();
#endif
