FrancescoLanthaler/BeeBeeAte/(commit log)

2021-10-26 First remote
    [BeeBeeAte-ESP32-V4.brd, BeeBeeAte-ESP32-V4.sch]
2021-10-26 Renaming files
    [BeeBeeAte-BotBoard.brd, BeeBeeAte-BotBoard.sch]
2021-10-26 Added Remote
    [BeeBeeAte-BotBoard_top_bom.csv, BeeBeeAte-RemoteBoard.brd, BeeBeeAte-RemoteBoard.sch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]
2021-10-26 Border put in milling layer
    [BeeBeeAte-RemoteBoard.brd]
2021-10-27 Completed BOM and CPL
    [BeeBeeAte-BotBoard.brd, BeeBeeAte-BotBoard_top_bom.csv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]
2021-10-27 Changed Gerber File to tValue
    [BeeBeeAte-BotBoard.sch]
2021-10-27 Added Logo to remote and created GERBER, BOM and CPL for remote
    [BeeBeeAte-RemoteBoard.brd, BeeBeeAte-RemoteBoard_top_bom.csv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]
2021-10-28 temp file
    [BeeBeeAte-BotBoard_top_bom.csv]
2021-11-01 Added 3,7V battery
    [BeeBeeAte-BotBoard.brd, BeeBeeAte-BotBoard.sch, BeeBeeAte-BotBoard_top_bom.csv, BeeBeeAte-BotBoard_top_bom_BACKUP_1247.csv, BeeBeeAte-BotBoard_top_bom_BASE_1247.csv, BeeBeeAte-BotBoard_top_bom_LOCAL_1247.csv]
2021-11-06 Added 3D Files and modified Board
    [BeeBeeAte-Bestelliste.csv, BeeBeeAte-BotBoard.brd, BeeBeeAte-BotBoard.sch, BeeBeeAte-RemoteBoard.brd, BeeBeeAte-RemoteBoard.sch, Cover-Test2.stl, Cover-Test3.stl]
2021-11-08 Checked by teacher and fixed
    [BeeBeeAte-BotBoard.brd, BeeBeeAte-BotBoard.sch, BeeBeeAte-RemoteBoard.brd]
2021-11-17 MILESTONE: PCB Ordered
    [BOM-BotBoard_BeeBeeAte.csv, BOM-RemoteBoard_BeeBeeAte.csv, BeeBeeAte-Bestelliste.csv, BeeBeeAte-BotBoard-Case_Test1.stl, BeeBeeAte-BotBoard-Case_Test2.stl, BeeBeeAte-BotBoard-Cover_Test1.stl, BeeBeeAte-BotBoard.brd, BeeBeeAte-BotBoard.sch]
2021-12-13 Added Header files (errors)
    [Omni Kupplung.stl]
2021-12-15 Added Motors
    [BOM-BotBoard_BeeBeeAte - Copy.csv, BeeBeeAte-BotBoard.brd, BeeBeeAte-BotBoard.sch, BeeBeeAte-RemoteBoard.sch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]
2021-12-15 Added Motorpins defines
2021-12-21 Added different files. Formula to calculate speed and function to control motors
2022-01-17 Erste Version des Algorythmus abgeschlossen
2022-01-29 Updated code and started editing PCB
    [BeeBeeAte-BotBoard.brd, BeeBeeAte-BotBoard.sch, BeeBeeAte-BotBoardV2.brd, BeeBeeAte-BotBoardV2.sch, BeeBeeAte-RemoteBoard.brd, BeeBeeAte-RemoteBoard.sch]
2022-02-07 New Board
    [BeeBeeAte-BotBoardV2.brd, BeeBeeAte-BotBoardV2.sch]
2022-02-16 Tried with PID loop
    [BeeBeeAte-BotBoardV2.brd]
2022-04-07 Halb Funktionierend mit PID-Regler
